Arti-Goldmann/IQcactus/software_m5stick/kaktus.png

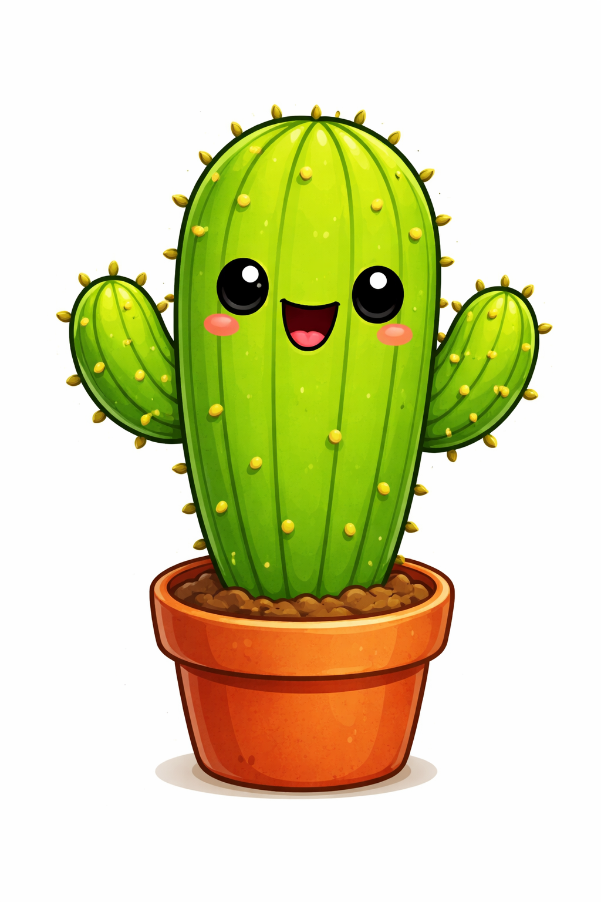
software_m5stick/kaktus.png
