Arti-Goldmann/IQcactus/software_m5stick/kaktus2.png

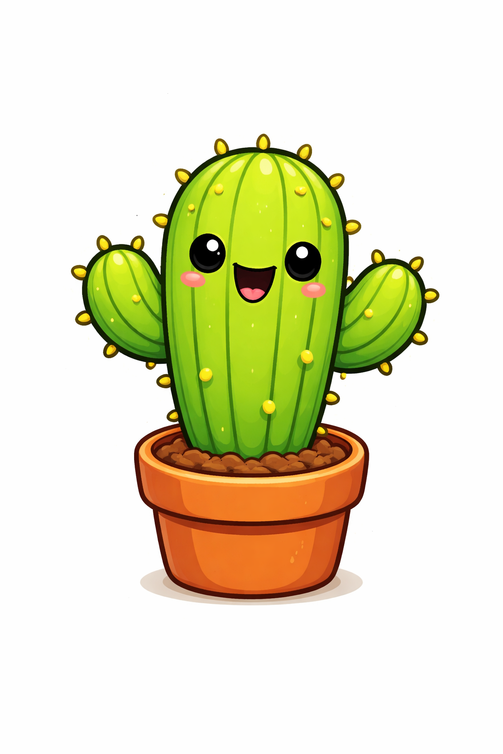
software_m5stick/kaktus2.png
