Arti-Goldmann/IQcactus/cactus_plate/cactus-silk-2.png

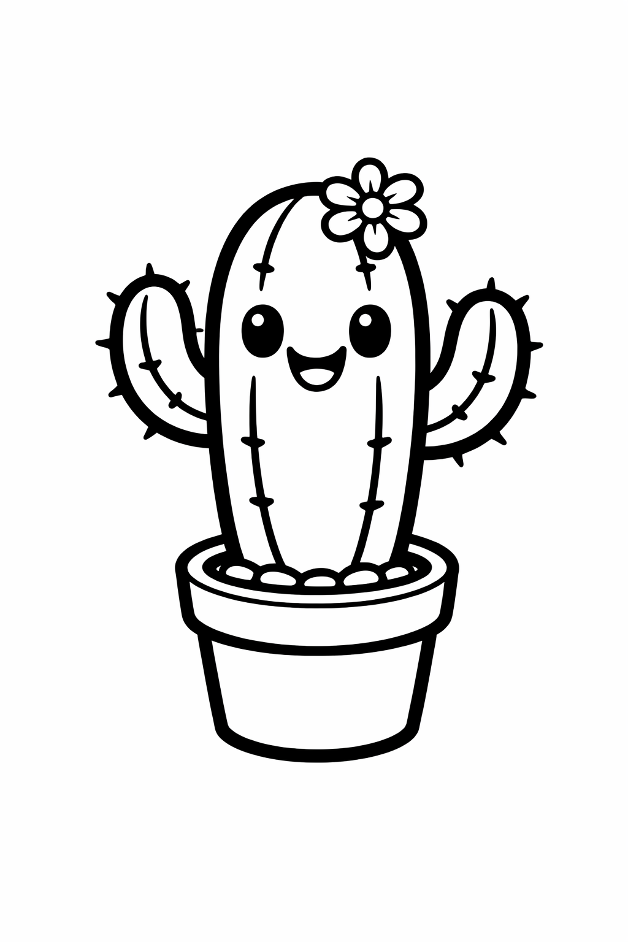
cactus_plate/cactus-silk-2.png
