Arti-Goldmann/IQcactus/cactus_plate/cactus-silk.png

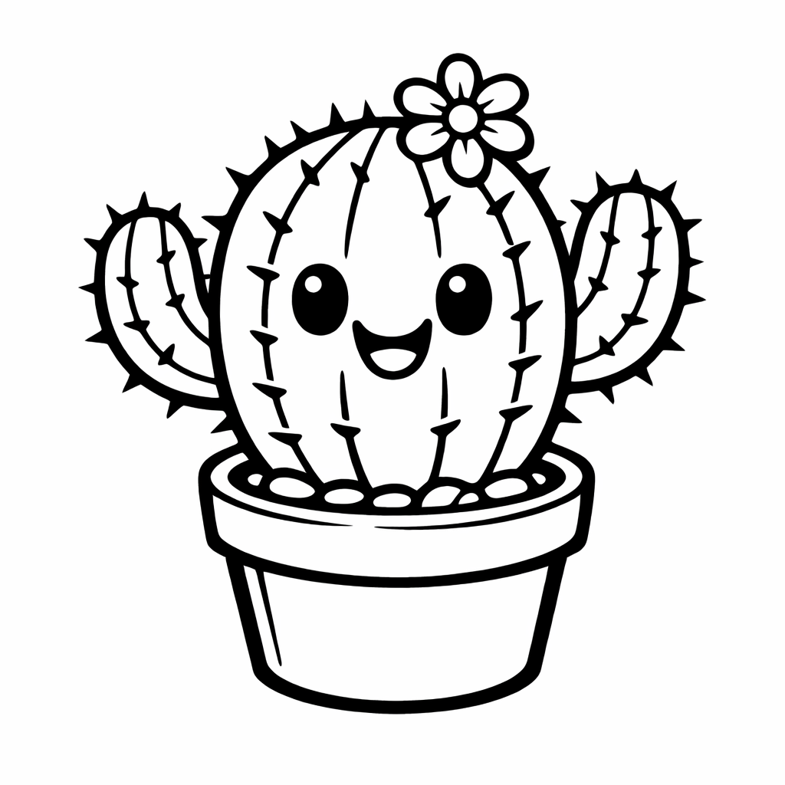
cactus_plate/cactus-silk.png
