Arti-Goldmann/IQcactus/software_m5stick/pixelart/kaktus_piskel/sprite_kaktus_raindrops1.png

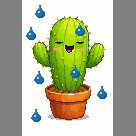
software_m5stick/pixelart/kaktus_piskel/sprite_kaktus_raindrops1.png
