Arti-Goldmann/IQcactus/software_m5stick/sprite_kaktus_daytime1_preview.png

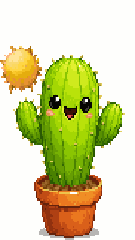
software_m5stick/sprite_kaktus_daytime1_preview.png
