Arti-Goldmann/IQcactus/model/body.FCStd

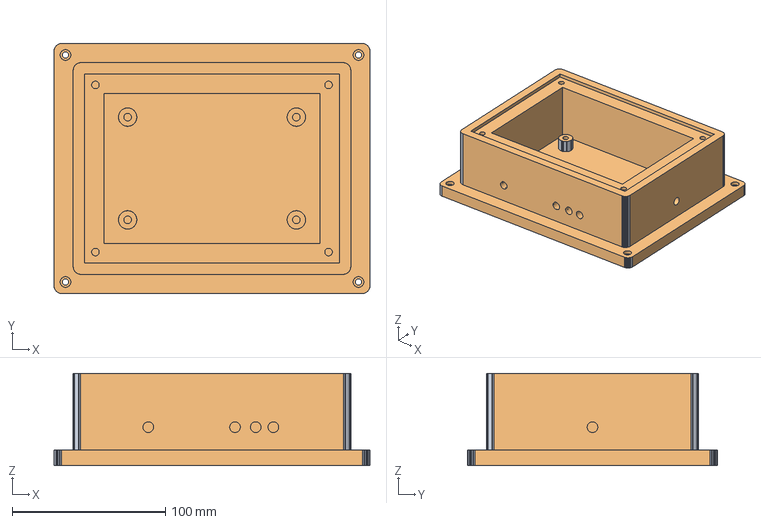
[picture p10: CAD file, 2026-04-19]
model/body.FCStd
206.0 x 163.0 x 60.0 mm
Тело
Тело (Meshed)
