Arti-Goldmann/IQcactus/model/body-Тело.3mf

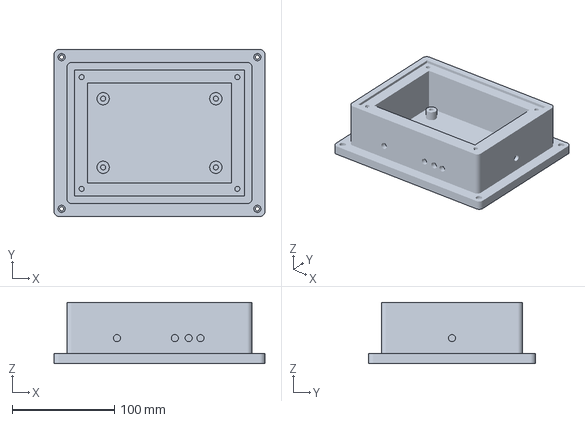
[picture p11: CAD file, 2026-04-19]
model/body-Тело.3mf
206.0 x 163.0 x 60.0 mm
