Arti-Goldmann/IQcactus/(list of files, cad)

Other CAD files:
model/body-Тело.stl
