Arti-Goldmann/IQcactus/cactus_plate/cactus_plate.kicad_pcb

## KiCad design cactus_plate/cactus_plate.kicad_pcb (2026-04-19)

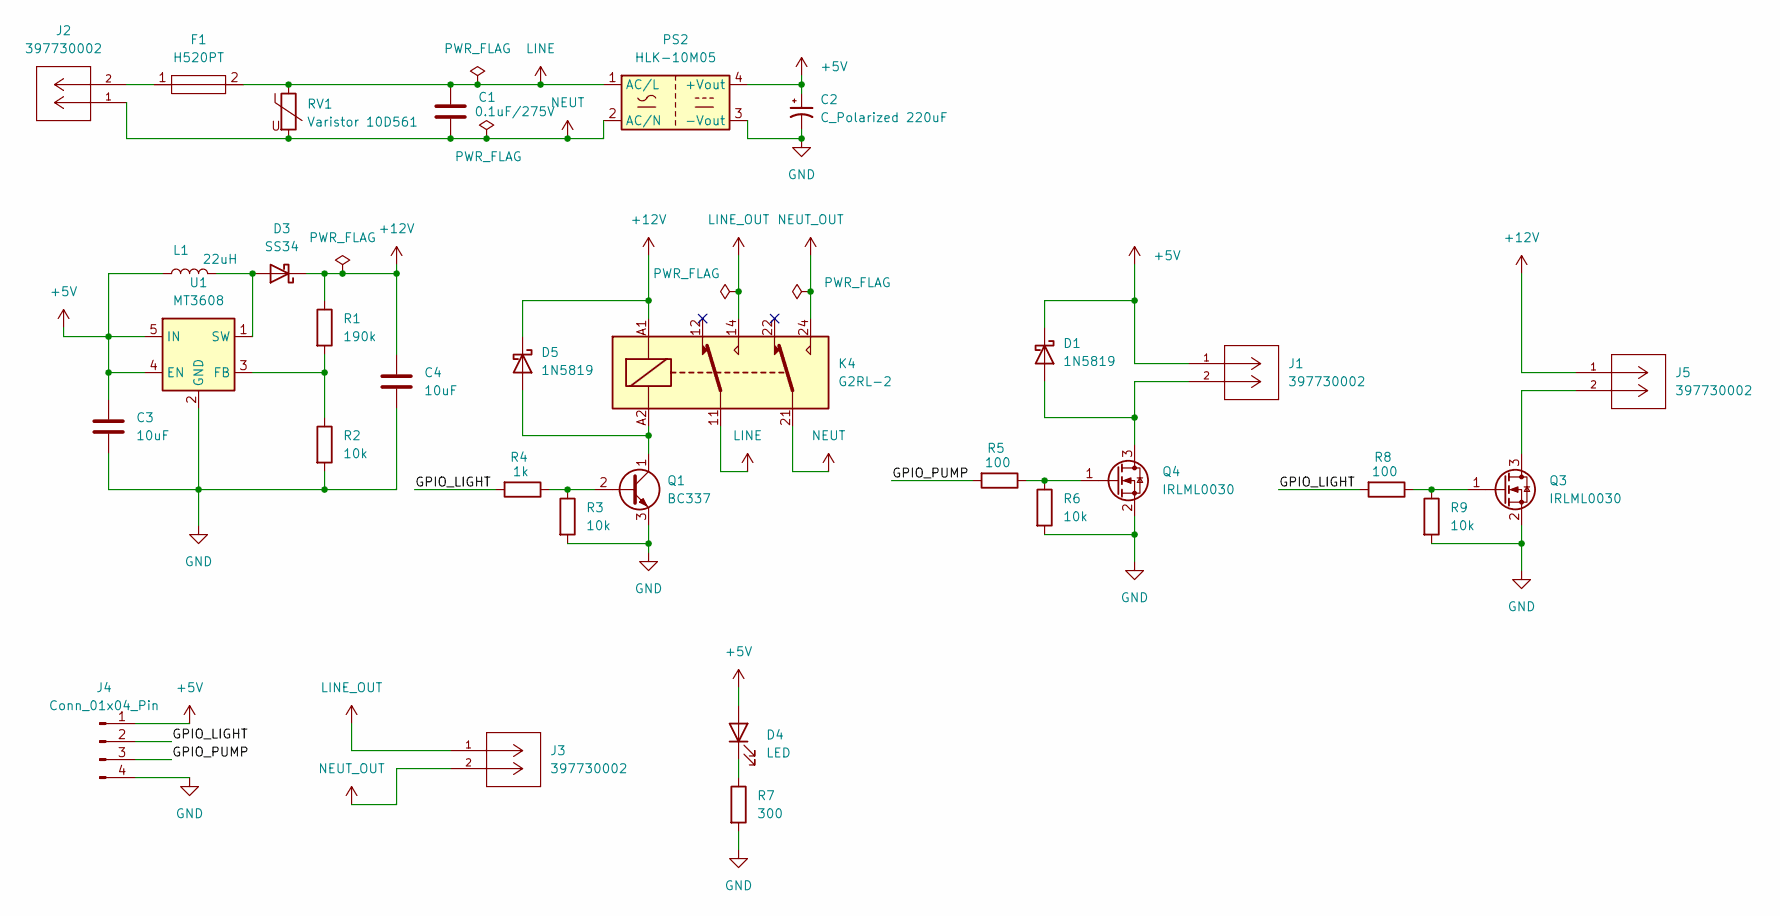
[picture p12: schematic cactus_plate.kicad_sch]

Parts:
C1: 0.1uF/275V; C_Axial_L12.0mm_D6.5mm_P15.00mm_Horizontal
C2: C_Polarized 220uF; CP_Radial_D10.0mm_P3.50mm
C3, C4: 10uF; C_0805_2012Metric_Pad1.18x1.45mm_HandSolder
D1, D5: 1N5819; D_DO-41_SOD81_P10.16mm_Horizontal
D3: SS34; D_SMA
D4: LED; R_0805_2012Metric_Pad1.20x1.40mm_HandSolder
F1: H520PT
J1, J2, J3, J5: 397730002; PhoenixContact_MCV_1,5_2-G-5.08_1x02_P5.08mm_Vertical; MANUFACTURER_PART_NUMBER 397730002
J4: Conn_01x04_Pin; PinHeader_1x04_P2.54mm_Vertical
K4: G2RL-2; Relay_DPDT_Omron_G2RL-2
L1: 22uH; L_10.4x10.4_H4.8
PS2: HLK-10M05; Converter_ACDC_Hi-Link_HLK-10Mxx
Q1: BC337; TO-92_Inline
Q3, Q4: IRLML0030; SOT-23
R1: 190k; R_0805_2012Metric_Pad1.20x1.40mm_HandSolder
R2, R3, R6, R9: 10k; R_0805_2012Metric_Pad1.20x1.40mm_HandSolder
R4: 1k; R_0805_2012Metric_Pad1.20x1.40mm_HandSolder
R5, R8: 100; R_0805_2012Metric_Pad1.20x1.40mm_HandSolder
R7: 300; R_0805_2012Metric_Pad1.20x1.40mm_HandSolder
RV1: Varistor 10D561; RV_Disc_D12mm_W5.8mm_P7.5mm
U1: MT3608; SOT-23-6

Connections:
+5V: C2.1, C3.1, D1.1 (K), D4.2 (A), J1.1, J4.1, L1.1, PS2.4 (+Vout), U1.4 (EN), U1.5 (IN)
+12V: C4.1, D3.1 (K), D5.1 (K), J5.1, K4.A1, R1.1
/GPIO_LIGHT: J4.2, R4.2, R8.2
/GPIO_PUMP: J4.3, R5.2
GND: C2.2, C3.2, C4.2, J4.4, PS2.3 (-Vout), Q1.3 (E), Q3.2 (S), Q4.2 (S), R2.2, R3.2, R6.2, R7.2, R9.2, U1.2 (GND)
LINE: C1.1, F1.2, K4.11, PS2.1 (AC/L), RV1.1
LINE_OUT: J3.1, K4.14
NEUT: C1.2, J2.1, K4.21, PS2.2 (AC/N), RV1.2
NEUT_OUT: J3.2, K4.24
unnamed: D1.2 (A), J1.2, Q4.3 (D)
unnamed: D3.2 (A), L1.2, U1.1 (SW)
unnamed: D4.1 (K), R7.1
unnamed: D5.2 (A), K4.A2, Q1.1 (C)
unnamed: F1.1, J2.2
unnamed: Q1.2 (B), R3.1, R4.1
unnamed: J5.2, Q3.3 (D)
unnamed: Q3.1 (G), R8.1, R9.1
unnamed: Q4.1 (G), R5.1, R6.1
unnamed: R1.2, R2.1, U1.3 (FB)

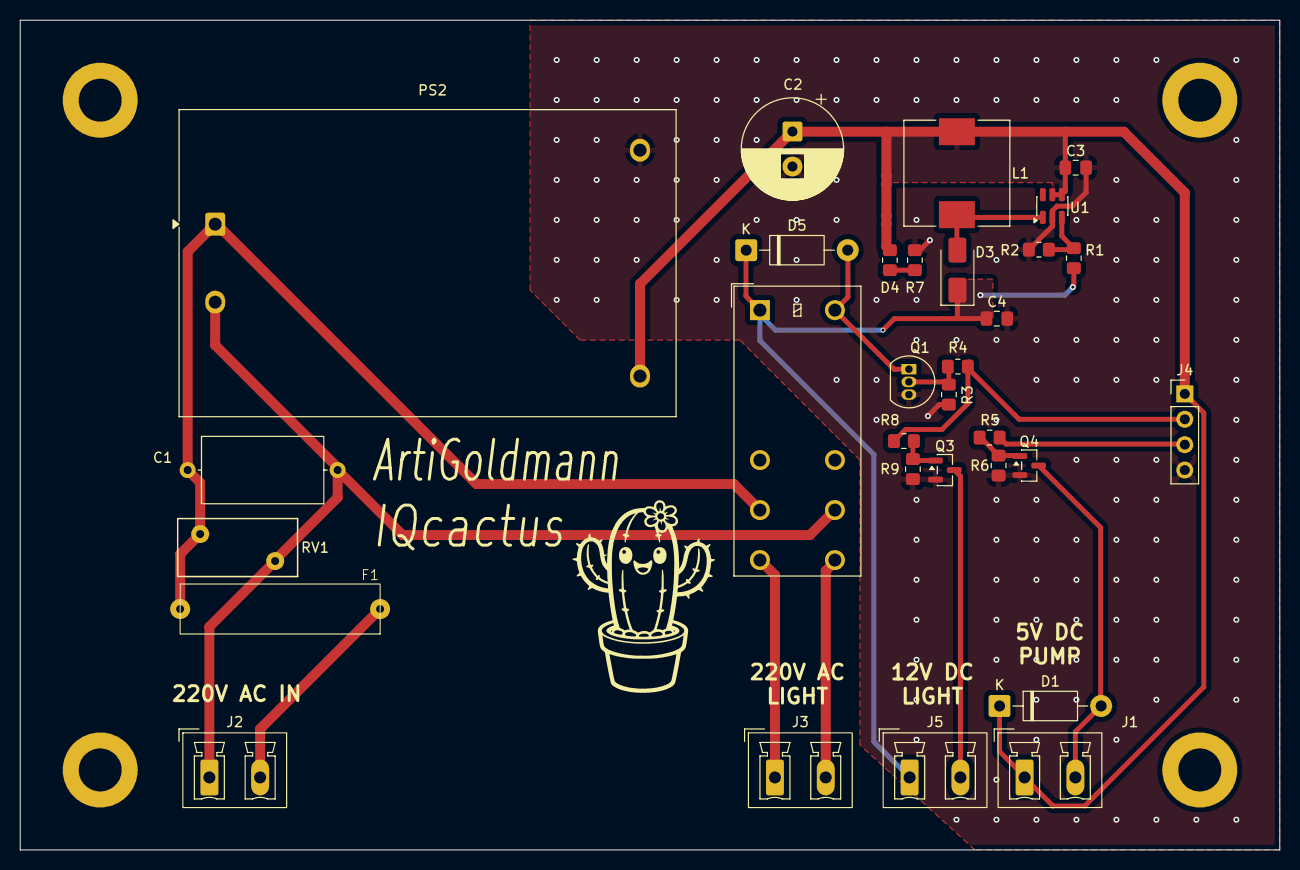
[picture p13: board cactus_plate.kicad_pcb from above]

Board: 2 copper layers, 126.0 x 83.0 mm, 31 parts (0 on the bottom side), 19 nets.
