Arti-Goldmann/IQcactus/software_m5stick/src/wifi.c

// src/wifi.c
#include "wifi.h"
#include "config.h"
#include <string.h>
#include <stdbool.h>
#include <time.h>
#include "freertos/FreeRTOS.h"
#include "freertos/task.h"
#include "freertos/event_groups.h"
#include "esp_wifi.h"
#include "esp_event.h"
#include "esp_log.h"
#include "esp_sntp.h"
#include "nvs_flash.h"

#define TAG "wifi"
#define WIFI_CONNECTED_BIT BIT0
#define WIFI_FAIL_BIT      BIT1
#define WIFI_MAX_RETRIES   5

static EventGroupHandle_t wifi_events;
static int retry_count = 0;

static void event_handler(void *arg, esp_event_base_t base,
                           int32_t event_id, void *event_data)
{
    if (base == WIFI_EVENT && event_id == WIFI_EVENT_STA_START) {
        esp_wifi_connect();
    } else if (base == WIFI_EVENT && event_id == WIFI_EVENT_STA_DISCONNECTED) {
        if (retry_count < WIFI_MAX_RETRIES) {
            esp_wifi_connect();
            retry_count++;
            ESP_LOGI(TAG, "retry %d/%d", retry_count, WIFI_MAX_RETRIES);
        } else {
            xEventGroupSetBits(wifi_events, WIFI_FAIL_BIT);
            ESP_LOGW(TAG, "connection failed");
        }
    } else if (base == IP_EVENT && event_id == IP_EVENT_STA_GOT_IP) {
        ip_event_got_ip_t *event = event_data;
        ESP_LOGI(TAG, "IP: " IPSTR, IP2STR(&event->ip_info.ip));
        retry_count = 0;
        xEventGroupSetBits(wifi_events, WIFI_CONNECTED_BIT);
    }
}

bool wifi_connect(void)
{
    ESP_ERROR_CHECK(nvs_flash_init());
    ESP_ERROR_CHECK(esp_netif_init());
    ESP_ERROR_CHECK(esp_event_loop_create_default());

    esp_netif_create_default_wifi_sta();

    wifi_init_config_t cfg = WIFI_INIT_CONFIG_DEFAULT();
    ESP_ERROR_CHECK(esp_wifi_init(&cfg));

    wifi_events = xEventGroupCreate();

    ESP_ERROR_CHECK(esp_event_handler_instance_register(
        WIFI_EVENT, ESP_EVENT_ANY_ID, event_handler, NULL, NULL));
    ESP_ERROR_CHECK(esp_event_handler_instance_register(
        IP_EVENT, IP_EVENT_STA_GOT_IP, event_handler, NULL, NULL));

    wifi_config_t wifi_cfg = {
        .sta = {
            .ssid     = WIFI_SSID,
            .password = WIFI_PASS,
        },
    };
    ESP_ERROR_CHECK(esp_wifi_set_mode(WIFI_MODE_STA));
    ESP_ERROR_CHECK(esp_wifi_set_config(WIFI_IF_STA, &wifi_cfg));
    ESP_ERROR_CHECK(esp_wifi_start());

    // Полностью отключаем Wi-Fi power save. Modem sleep вводил CPU в light-sleep
    // ~80% времени, после чего SPI-периферия LCD теряла завершение DMA-транзакции
    // и esp_lcd_panel_draw_bitmap зависал на семафоре навсегда.
    ESP_ERROR_CHECK(esp_wifi_set_ps(WIFI_PS_NONE));

    EventBits_t bits = xEventGroupWaitBits(wifi_events,
        WIFI_CONNECTED_BIT | WIFI_FAIL_BIT, pdFALSE, pdFALSE,
        pdMS_TO_TICKS(15000));

    return (bits & WIFI_CONNECTED_BIT) != 0;
}

void sntp_sync_start(void)
{
    esp_sntp_setoperatingmode(SNTP_OPMODE_POLL);
    esp_sntp_setservername(0, "pool.ntp.org");
    esp_sntp_init();
    ESP_LOGI(TAG, "SNTP started");
}

bool sntp_wait_sync(uint32_t timeout_ms)
{
    uint32_t elapsed = 0;
    while (elapsed < timeout_ms) {
        if (sntp_get_sync_status() == SNTP_SYNC_STATUS_COMPLETED) {
            time_t now;
            time(&now);
            ESP_LOGI(TAG, "SNTP synced: %lld", (long long)now);
            return true;
        }
        vTaskDelay(pdMS_TO_TICKS(500));
        elapsed += 500;
    }
    ESP_LOGW(TAG, "SNTP sync timeout");
    return false;
}
