Arti-Goldmann/IQcactus/(commit log)

2026-03-21 Версия без подсветки
    [cactus_plate-B_Cu.gbr, cactus_plate-B_Mask.gbr, cactus_plate-B_Paste.gbr, cactus_plate-B_Silkscreen.gbr, cactus_plate-Edge_Cuts.gbr, cactus_plate-F_Cu.gbr, cactus_plate-F_Mask.gbr, cactus_plate-F_Paste.gbr]
2026-03-22 Переделал плату, добавил разъем для подсветки
    [cactus_plate-B_Cu.gbr, cactus_plate-B_Mask.gbr, cactus_plate-B_Paste.gbr, cactus_plate-B_Silkscreen.gbr, cactus_plate-Edge_Cuts.gbr, cactus_plate-F_Cu.gbr, cactus_plate-F_Mask.gbr, cactus_plate-F_Paste.gbr]
2026-04-19 сделал 3d модель корпуса
    [body-Тело.3mf, body-Тело.stl, body.FCStd, cactus_plate.kicad_pcb]
2026-05-24 начал делать софт для m5stick
2026-05-24 устанановил соединение с сервером
    [partitions.csv]
2026-05-24 полинг сервера каждую секунду
2026-05-24 фикс дисплея
2026-05-24 spi через прерывания, а не через dma, а то дисплей подвисал
